m24h/espcnc/Readme.txt

A 3D printer or CNC controller using ESP32 module
Using DMA/FIFO buffered I2S port to output step pulses
