m24h/espcnc/hardware/espcnc_print.pdf

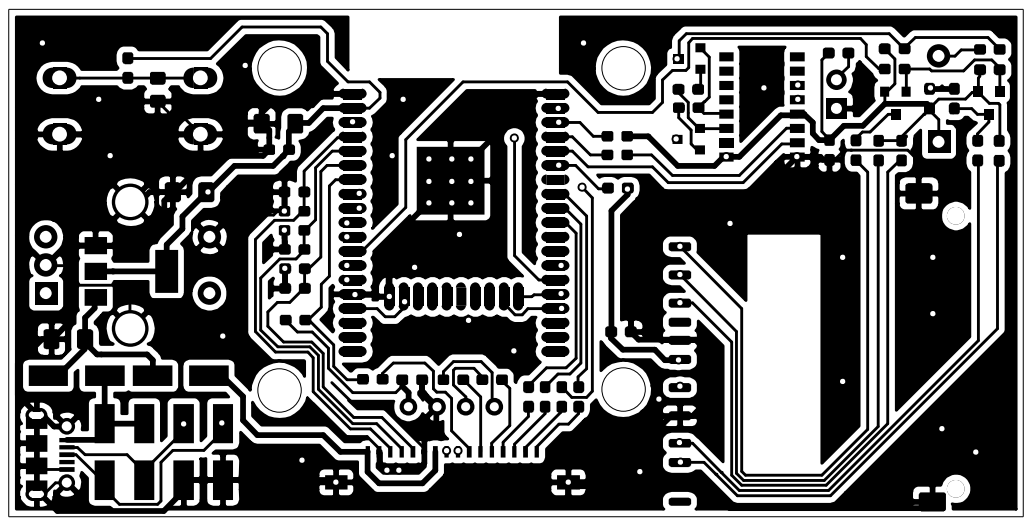
[picture p1: page 1]

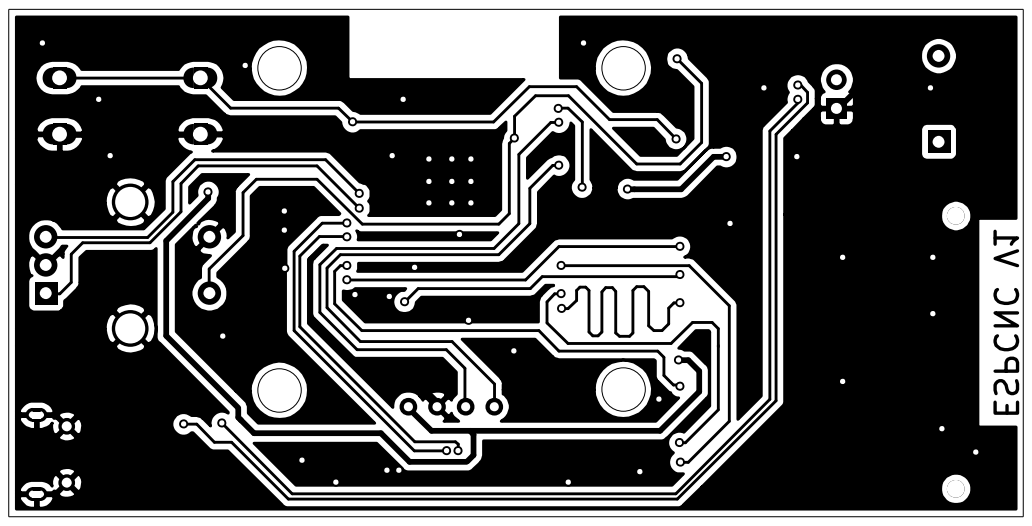
[picture p2: page 2]

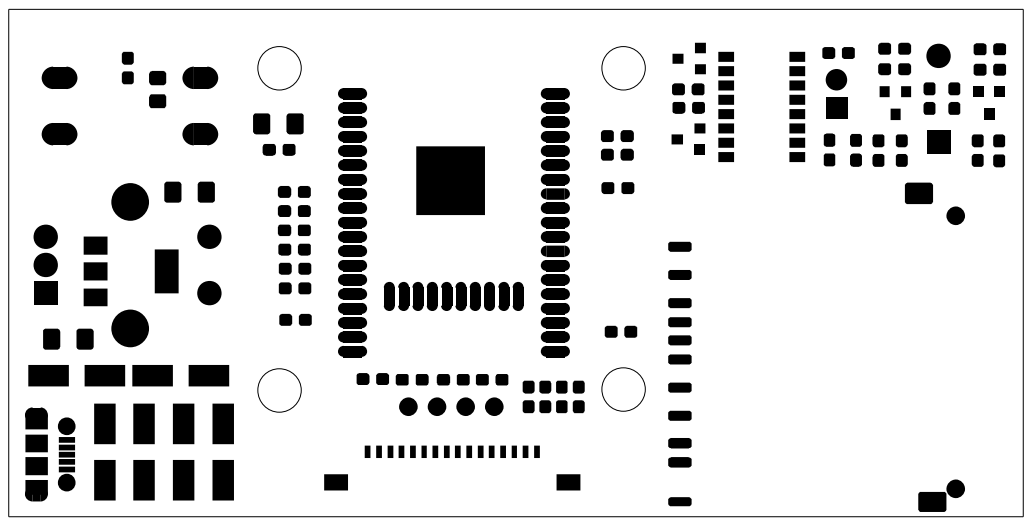
[picture p3: page 3]

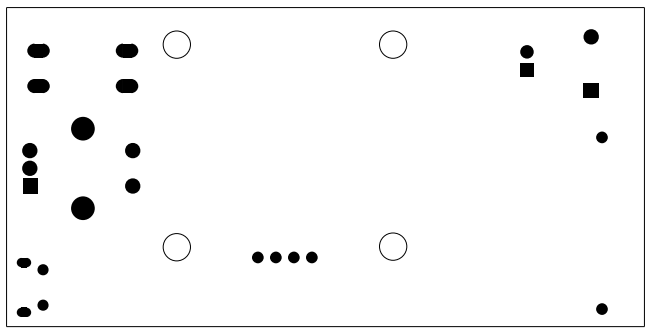
[picture p4: figure]
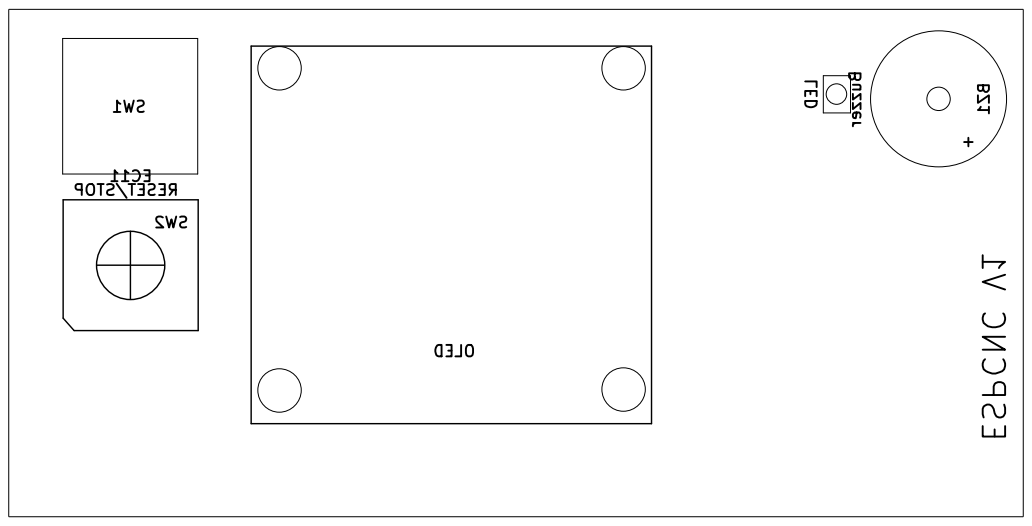
[picture p5: page 5]
