m24h/espcnc/hardware/driver.kicad_pcb

## KiCad design hardware/driver.kicad_pcb (2020-03-21)

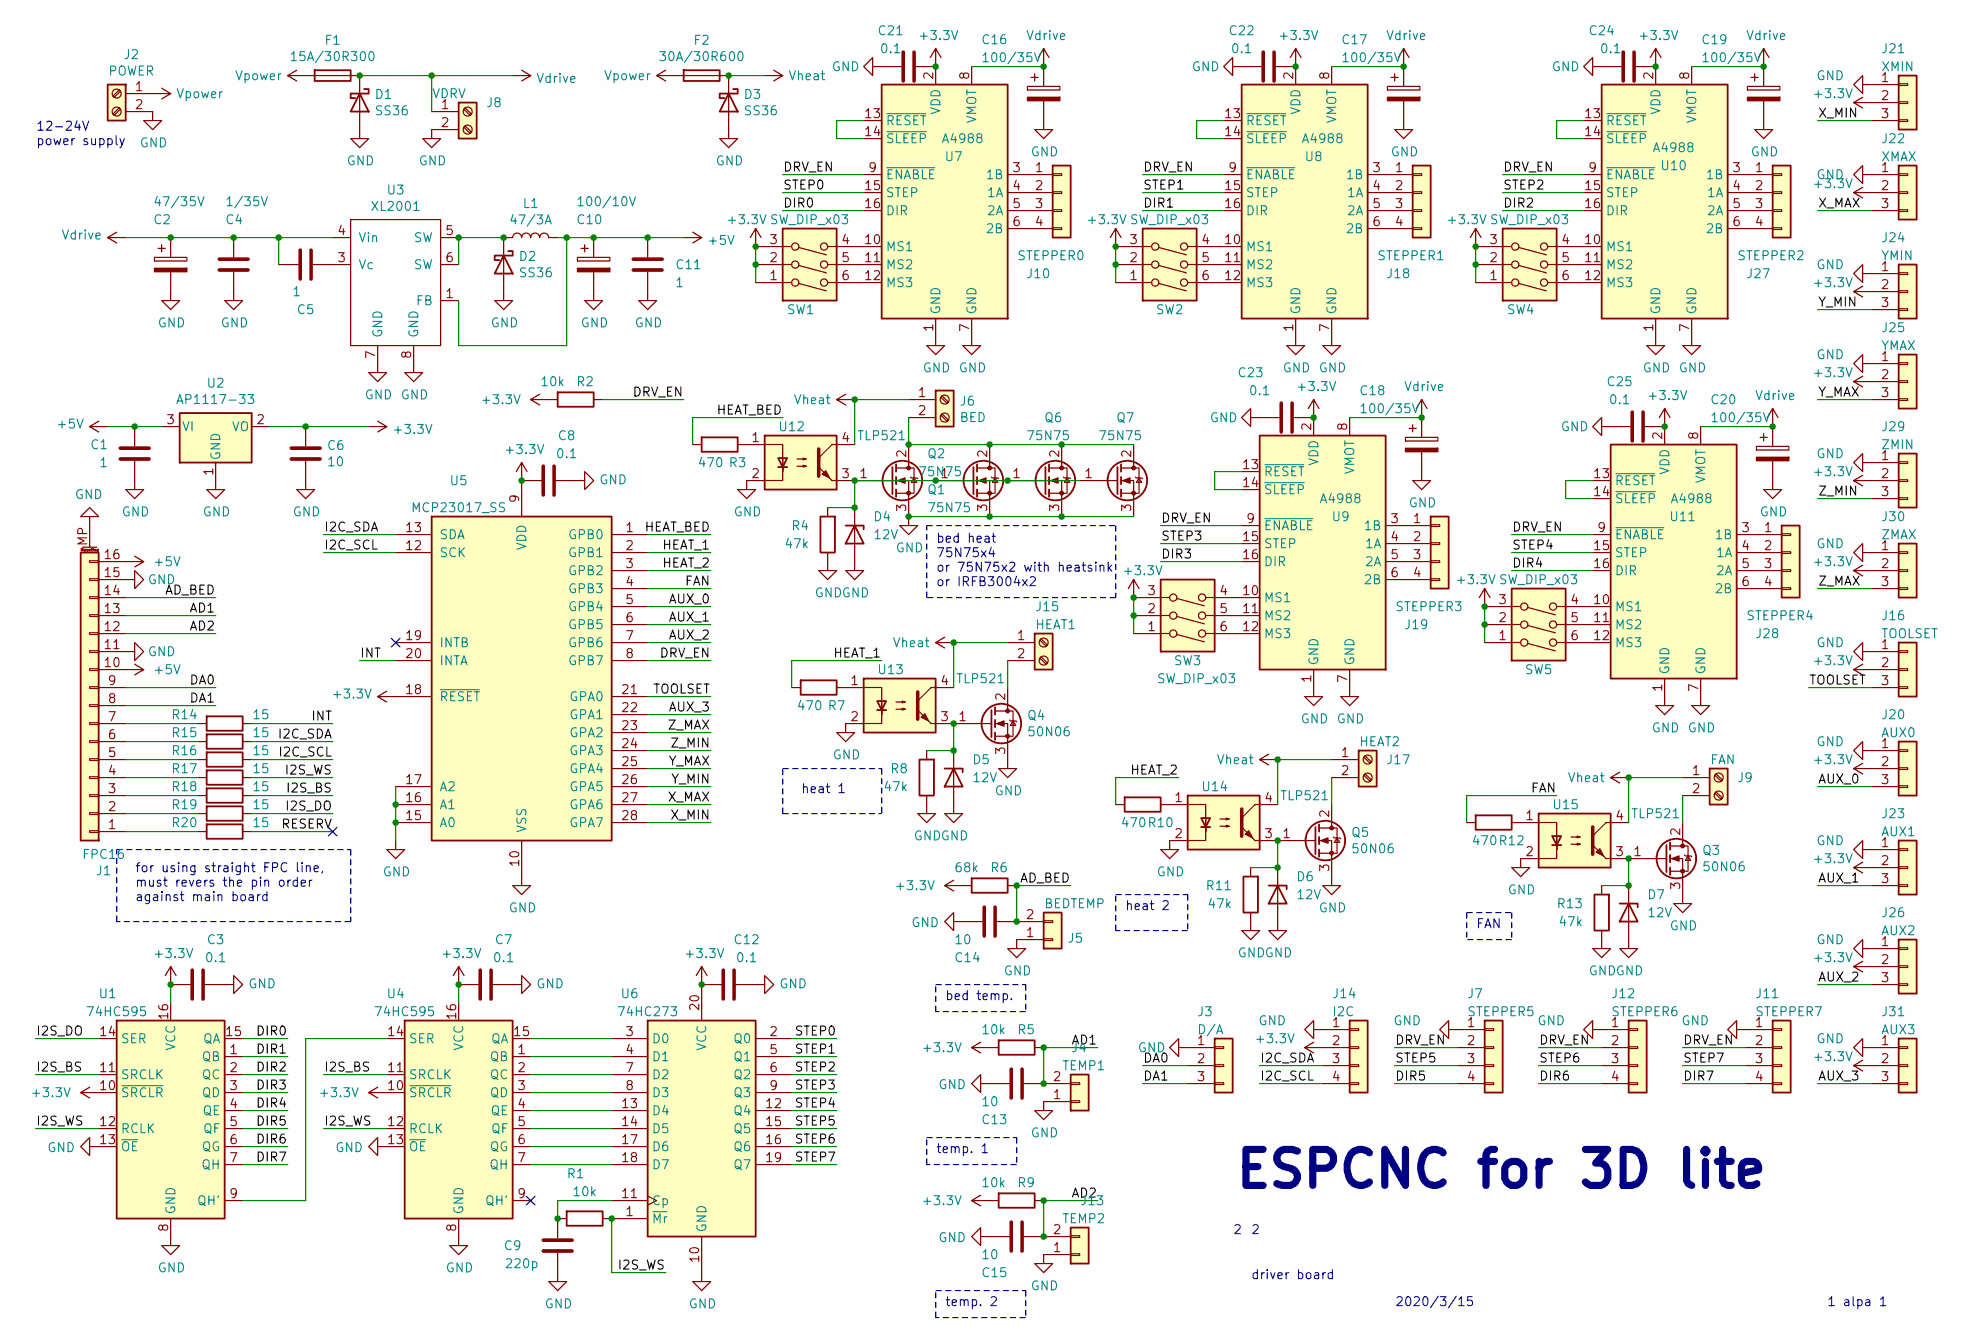
[picture p12: schematic driver.sch]

Parts:
C1, C5, C11: 1; C_0805_2012Metric_Pad1.15x1.40mm_HandSolder
C2: 47/35V; CP_Radial_D6.3mm_P2.50mm
C3, C7, C8, C12, C21, C22, C23, C24, C25: 0.1; C_0603_1608Metric_Pad1.05x0.95mm_HandSolder
C4: 1/35V; C_0805_2012Metric_Pad1.15x1.40mm_HandSolder
C6, C13, C14, C15: 10; C_1206_3216Metric_Pad1.42x1.75mm_HandSolder
C9: 220p; C_0603_1608Metric_Pad1.05x0.95mm_HandSolder
C10: 100/10V; CP_Radial_D6.3mm_P2.50mm
C16, C17, C18, C19, C20: 100/35V; CP_Radial_D6.3mm_P2.50mm
D1, D2, D3: SS36; D_SMA_Handsoldering
D4, D5, D6, D7: 12V; D_DO-41_SOD81_P2.54mm_Vertical_KathodeUp
F1: 15A/30R300; Fuse_Bourns_MF-RG300
F2: 30A/30R600; Fuse_Bourns_MF-RG500
J1: FPC16; Molex_200528-0160_1x16-1MP_P1.00mm_Horizontal
J2: POWER; TerminalBlock_bornier-2_P5.08mm
J3: D/A; PinHeader_1x03_P2.54mm_Vertical
J4: TEMP1; PinHeader_1x02_P2.54mm_Vertical
J5: BEDTEMP; PinHeader_1x02_P2.54mm_Vertical
J6: BED; TerminalBlock_bornier-2_P5.08mm
J7: STEPPER5; PinHeader_1x04_P2.54mm_Vertical
J8: VDRV; TerminalBlock_bornier-2_P5.08mm
J9: FAN; TerminalBlock_bornier-2_P5.08mm
J10: STEPPER0; PinHeader_1x04_P2.54mm_Vertical
J11: STEPPER7; PinHeader_1x04_P2.54mm_Vertical
J12: STEPPER6; PinHeader_1x04_P2.54mm_Vertical
J13: TEMP2; PinHeader_1x02_P2.54mm_Vertical
J14: I2C; PinHeader_1x04_P2.54mm_Vertical
J15: HEAT1; TerminalBlock_bornier-2_P5.08mm
J16: TOOLSET; PinHeader_1x03_P2.54mm_Vertical
J17: HEAT2; TerminalBlock_bornier-2_P5.08mm
J18: STEPPER1; PinHeader_1x04_P2.54mm_Vertical
J19: STEPPER3; PinHeader_1x04_P2.54mm_Vertical
J20: AUX0; PinHeader_1x03_P2.54mm_Vertical
J21: XMIN; PinHeader_1x03_P2.54mm_Vertical
J22: XMAX; PinHeader_1x03_P2.54mm_Vertical
J23: AUX1; PinHeader_1x03_P2.54mm_Vertical
J24: YMIN; PinHeader_1x03_P2.54mm_Vertical
J25: YMAX; PinHeader_1x03_P2.54mm_Vertical
J26: AUX2; PinHeader_1x03_P2.54mm_Vertical
J27: STEPPER2; PinHeader_1x04_P2.54mm_Vertical
J28: STEPPER4; PinHeader_1x04_P2.54mm_Vertical
J29: ZMIN; PinHeader_1x03_P2.54mm_Vertical
J30: ZMAX; PinHeader_1x03_P2.54mm_Vertical
J31: AUX3; PinHeader_1x03_P2.54mm_Vertical
L1: 47/3A; L_Toroid_Horizontal_D7.8mm_P13.00mm_Diameter9-5mm_Amidon-T30
Q1, Q2, Q6, Q7: 75N75; TO-220-3_Vertical
Q3, Q4, Q5: 50N06; TO-220-3_Vertical
R1, R2, R5, R9: 10k; R_0603_1608Metric_Pad1.05x0.95mm_HandSolder
R3, R7, R10, R12: 470; R_0603_1608Metric_Pad1.05x0.95mm_HandSolder
R4, R8, R11, R13: 47k; R_0603_1608Metric_Pad1.05x0.95mm_HandSolder
R6: 68k; R_0603_1608Metric_Pad1.05x0.95mm_HandSolder
R14, R15, R16, R17, R18, R19, R20: 15; R_0603_1608Metric_Pad1.05x0.95mm_HandSolder
SW1, SW2, SW3, SW4, SW5: SW_DIP_x03; DIP-6_W7.62mm
U1, U4: 74HC595; SOP-16_4.55x10.3mm_P1.27mm
U2: AP1117-33; SOT-223-3_TabPin2
U3: XL2001; SOP-8_5.28x5.23mm_P1.27mm
U5: MCP23017_SS; SSOP-28_5.3x10.2mm_P0.65mm
U6: 74HC273; SOIC-20W_7.5x12.8mm_P1.27mm
U7, U8, U9, U10, U11: A4988; Pololu_Breakout-16_15.2x20.3mm
U12, U13, U14, U15: TLP521; DIP-4_W7.62mm

Connections:
+3V3: C3.2, C6.1, C7.2, C8.2, C12.2, C21.1, C22.1, C23.1, C24.1, C25.1, J14.2, J16.2, J20.2, J21.2, J22.2, J23.2, J24.2, J25.2, J26.2, J29.2, J30.2, J31.2, R2.2, R5.2, R6.2, R9.2, SW1.1, SW1.2, SW1.3, SW2.1, SW2.2, SW2.3, SW3.1, SW3.2, SW3.3, SW4.1, SW4.2, SW4.3, SW5.1, SW5.2, SW5.3, U1.10 (~SRCLR), U1.16 (VCC), U2.2 (VO), U4.10 (~SRCLR), U4.16 (VCC), U5.9 (VDD), U5.18 (~RESET~), U6.20 (VCC), U7.2 (VDD), U8.2 (VDD), U9.2 (VDD), U10.2 (VDD), U11.2 (VDD)
+5V: C1.1, C10.1, C11.1, J1.10, J1.16, L1.2, U2.3 (VI), U3.1 (FB)
/AD1: C13.1, J1.13, J4.2, R5.1
/AD2: C15.1, J1.12, J13.2, R9.1
/AD_BED: C14.1, J1.14, J5.2, R6.1
/AUX_0: J20.3, U5.5 (GPB4)
/AUX_1: J23.3, U5.6 (GPB5)
/AUX_2: J26.3, U5.7 (GPB6)
/AUX_3: J31.3, U5.22 (GPA1)
/DA0: J1.9, J3.2
/DA1: J1.8, J3.3
/DIR0: U1.15 (QA), U7.16 (DIR)
/DIR1: U1.1 (QB), U8.16 (DIR)
/DIR2: U1.2 (QC), U10.16 (DIR)
/DIR3: U1.3 (QD), U9.16 (DIR)
/DIR4: U1.4 (QE), U11.16 (DIR)
/DIR5: J7.4, U1.5 (QF)
/DIR6: J12.4, U1.6 (QG)
/DIR7: J11.4, U1.7 (QH)
/DRV_EN: J7.2, J11.2, J12.2, R2.1, U5.8 (GPB7), U7.9 (~ENABLE), U8.9 (~ENABLE), U9.9 (~ENABLE), U10.9 (~ENABLE), U11.9 (~ENABLE)
/FAN: R12.2, U5.4 (GPB3)
/HEAT_1: R7.2, U5.2 (GPB1)
/HEAT_2: R10.2, U5.3 (GPB2)
/HEAT_BED: R3.2, U5.1 (GPB0)
/I2C_SCL: J14.4, R16.1, U5.12 (SCK)
/I2C_SDA: J14.3, R15.1, U5.13 (SDA)
/I2S_BS: R18.1, U1.11 (SRCLK), U4.11 (SRCLK)
/I2S_DO: R19.1, U1.14 (SER)
/I2S_WS: R1.1, R17.1, U1.12 (RCLK), U4.12 (RCLK), U6.1 (~Mr)
/INT: R14.1, U5.20 (INTA)
/RESERV: R20.1
/STEP0: U6.2 (Q0), U7.15 (STEP)
/STEP1: U6.5 (Q1), U8.15 (STEP)
/STEP2: U6.6 (Q2), U10.15 (STEP)
/STEP3: U6.9 (Q3), U9.15 (STEP)
/STEP4: U6.12 (Q4), U11.15 (STEP)
/STEP5: J7.3, U6.15 (Q5)
/STEP6: J12.3, U6.16 (Q6)
/STEP7: J11.3, U6.19 (Q7)
/TOOLSET: J16.3, U5.21 (GPA0)
/X_MAX: J22.3, U5.27 (GPA6)
/X_MIN: J21.3, U5.28 (GPA7)
/Y_MAX: J25.3, U5.25 (GPA4)
/Y_MIN: J24.3, U5.26 (GPA5)
/Z_MAX: J30.3, U5.23 (GPA2)
/Z_MIN: J29.3, U5.24 (GPA3)
GND: C1.2, C2.2, C3.1, C4.2, C6.2, C7.1, C8.1, C9.1, C10.2, C11.2, C12.1, C13.2, C14.2, C15.2, C16.2, C17.2, C18.2, C19.2, C20.2, C21.2, C22.2, C23.2, C24.2, C25.2, D1.2 (A), D2.2 (A), D3.2 (A), D4.2 (A), D5.2 (A), D6.2 (A), D7.2 (A), J1.11, J1.15, J1.MP (MountPin), J2.2, J3.1, J4.1, J5.1, J7.1, J8.2, J11.1, J12.1, J13.1, J14.1, J16.1, J20.1, J21.1, J22.1, J23.1, J24.1, J25.1, J26.1, J29.1, J30.1, J31.1, Q1.3 (S), Q2.3 (S), Q3.3 (S), Q4.3 (S), Q5.3 (S), Q6.3 (S), Q7.3 (S), R4.1, R8.1, R11.1, R13.1, U1.8 (GND), U1.13 (~OE), U2.1 (GND), U3.7 (GND), U3.8 (GND), U4.8 (GND), U4.13 (~OE), U5.10 (VSS), U5.15 (A0), U5.16 (A1), U5.17 (A2), U6.10 (GND), U7.1 (GND), U7.7 (GND), U8.1 (GND), U8.7 (GND), U9.1 (GND), U9.7 (GND), U10.1 (GND), U10.7 (GND), U11.1 (GND), U11.7 (GND), U12.2, U13.2, U14.2, U15.2
unnamed: C5.1, U3.3 (Vc)
unnamed: C9.2, R1.2, U6.11 (Cp)
unnamed: D2.1 (K), L1.1, U3.5 (SW), U3.6 (SW)
unnamed: D4.1 (K), Q1.1 (G), Q2.1 (G), Q6.1 (G), Q7.1 (G), R4.2, U12.3
unnamed: D5.1 (K), Q4.1 (G), R8.2, U13.3
unnamed: D6.1 (K), Q5.1 (G), R11.2, U14.3
unnamed: D7.1 (K), Q3.1 (G), R13.2, U15.3
unnamed: J1.1, R20.2
unnamed: J1.2, R19.2
unnamed: J1.3, R18.2
unnamed: J1.4, R17.2
unnamed: J1.5, R16.2
unnamed: J1.6, R15.2
unnamed: J1.7, R14.2
unnamed: J6.2, Q1.2 (D), Q2.2 (D), Q6.2 (D), Q7.2 (D)
unnamed: J9.2, Q3.2 (D)
unnamed: J10.1, U7.3 (1B)
unnamed: J10.2, U7.4 (1A)
unnamed: J10.3, U7.5 (2A)
unnamed: J10.4, U7.6 (2B)
unnamed: J15.2, Q4.2 (D)
unnamed: J17.2, Q5.2 (D)
unnamed: J18.1, U8.3 (1B)
unnamed: J18.2, U8.4 (1A)
unnamed: J18.3, U8.5 (2A)
unnamed: J18.4, U8.6 (2B)
unnamed: J19.1, U9.3 (1B)
unnamed: J19.2, U9.4 (1A)
unnamed: J19.3, U9.5 (2A)
unnamed: J19.4, U9.6 (2B)
unnamed: J27.1, U10.3 (1B)
unnamed: J27.2, U10.4 (1A)
unnamed: J27.3, U10.5 (2A)
unnamed: J27.4, U10.6 (2B)
unnamed: J28.1, U11.3 (1B)
unnamed: J28.2, U11.4 (1A)
unnamed: J28.3, U11.5 (2A)
unnamed: J28.4, U11.6 (2B)
unnamed: R3.1, U12.1
unnamed: R7.1, U13.1
unnamed: R10.1, U14.1
unnamed: R12.1, U15.1
unnamed: SW1.4, U7.10 (MS1)
unnamed: SW1.5, U7.11 (MS2)
unnamed: SW1.6, U7.12 (MS3)
unnamed: SW2.4, U8.10 (MS1)
unnamed: SW2.5, U8.11 (MS2)
unnamed: SW2.6, U8.12 (MS3)
unnamed: SW3.4, U9.10 (MS1)
unnamed: SW3.5, U9.11 (MS2)
unnamed: SW3.6, U9.12 (MS3)
unnamed: SW4.4, U10.10 (MS1)
unnamed: SW4.5, U10.11 (MS2)
unnamed: SW4.6, U10.12 (MS3)
unnamed: SW5.4, U11.10 (MS1)
unnamed: SW5.5, U11.11 (MS2)
unnamed: SW5.6, U11.12 (MS3)
unnamed: U1.9 (QH'), U4.14 (SER)
unnamed: U4.1 (QB), U6.4 (D1)
unnamed: U4.2 (QC), U6.7 (D2)
unnamed: U4.3 (QD), U6.8 (D3)
unnamed: U4.4 (QE), U6.13 (D4)
unnamed: U4.5 (QF), U6.14 (D5)
unnamed: U4.6 (QG), U6.17 (D6)
unnamed: U4.7 (QH), U6.18 (D7)
unnamed: U4.15 (QA), U6.3 (D0)
unnamed: U7.13 (~RESET), U7.14 (~SLEEP)
unnamed: U8.13 (~RESET), U8.14 (~SLEEP)
unnamed: U9.13 (~RESET), U9.14 (~SLEEP)
unnamed: U10.13 (~RESET), U10.14 (~SLEEP)
unnamed: U11.13 (~RESET), U11.14 (~SLEEP)
Vdrive: C2.1, C4.1, C5.2, C16.1, C17.1, C18.1, C19.1, C20.1, D1.1 (K), F1.1, J8.1, U3.4 (Vin), U7.8 (VMOT), U8.8 (VMOT), U9.8 (VMOT), U10.8 (VMOT), U11.8 (VMOT)
Vheat: D3.1 (K), F2.1, J6.1, J9.1, J15.1, J17.1, U12.4, U13.4, U14.4, U15.4
Vpower: F1.2, F2.2, J2.1

Notes on the sheet:
ESPCNC for 3D lite
2020/3/15
driver board
1 alpa 1
bed temp.
12-24V power supply
bed heat 75N75x4 or 75N75x2 with heatsink or IRFB3004x2
heat 2
heat 1
temp. 1
temp. 2
FAN
for using straight FPC line, must revers the pin order against main board

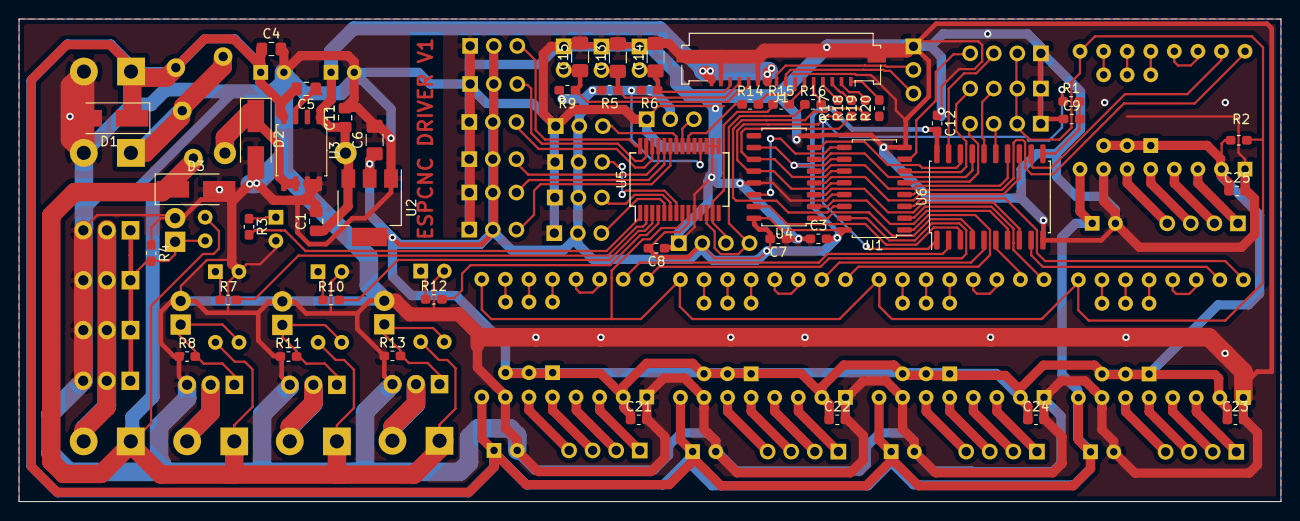
[picture p13: board driver.kicad_pcb from above]

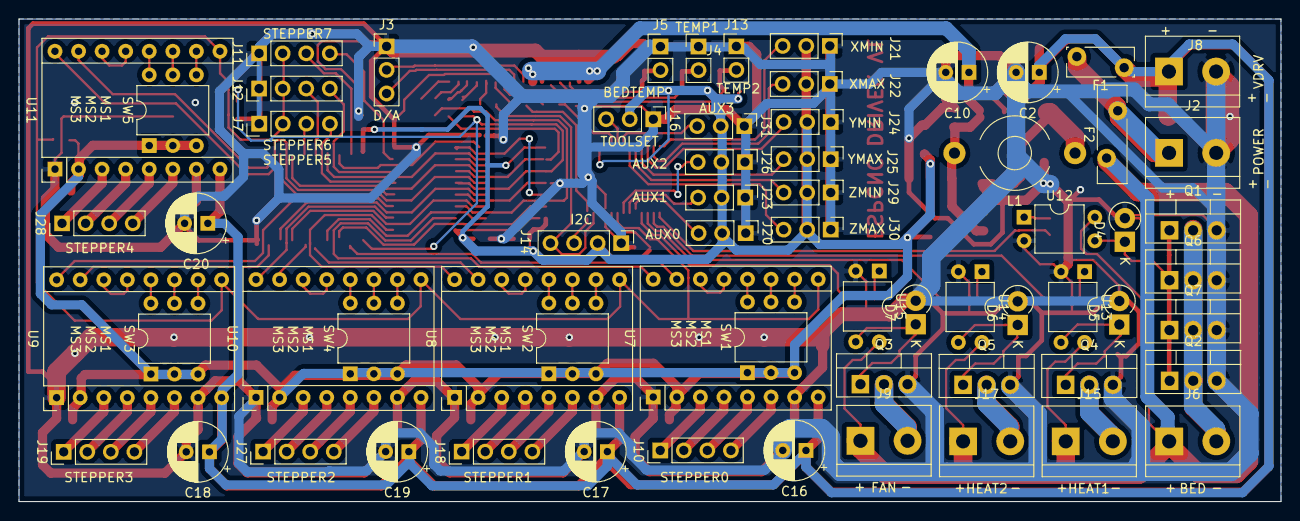
[picture p14: board driver.kicad_pcb from below]

Board: 2 copper layers, 136.0 x 52.0 mm, 113 parts (65 on the bottom side), 120 nets.
