m24h/espcnc/hardware/espcnc.kicad_pcb

## KiCad design hardware/espcnc.kicad_pcb (2020-03-21)

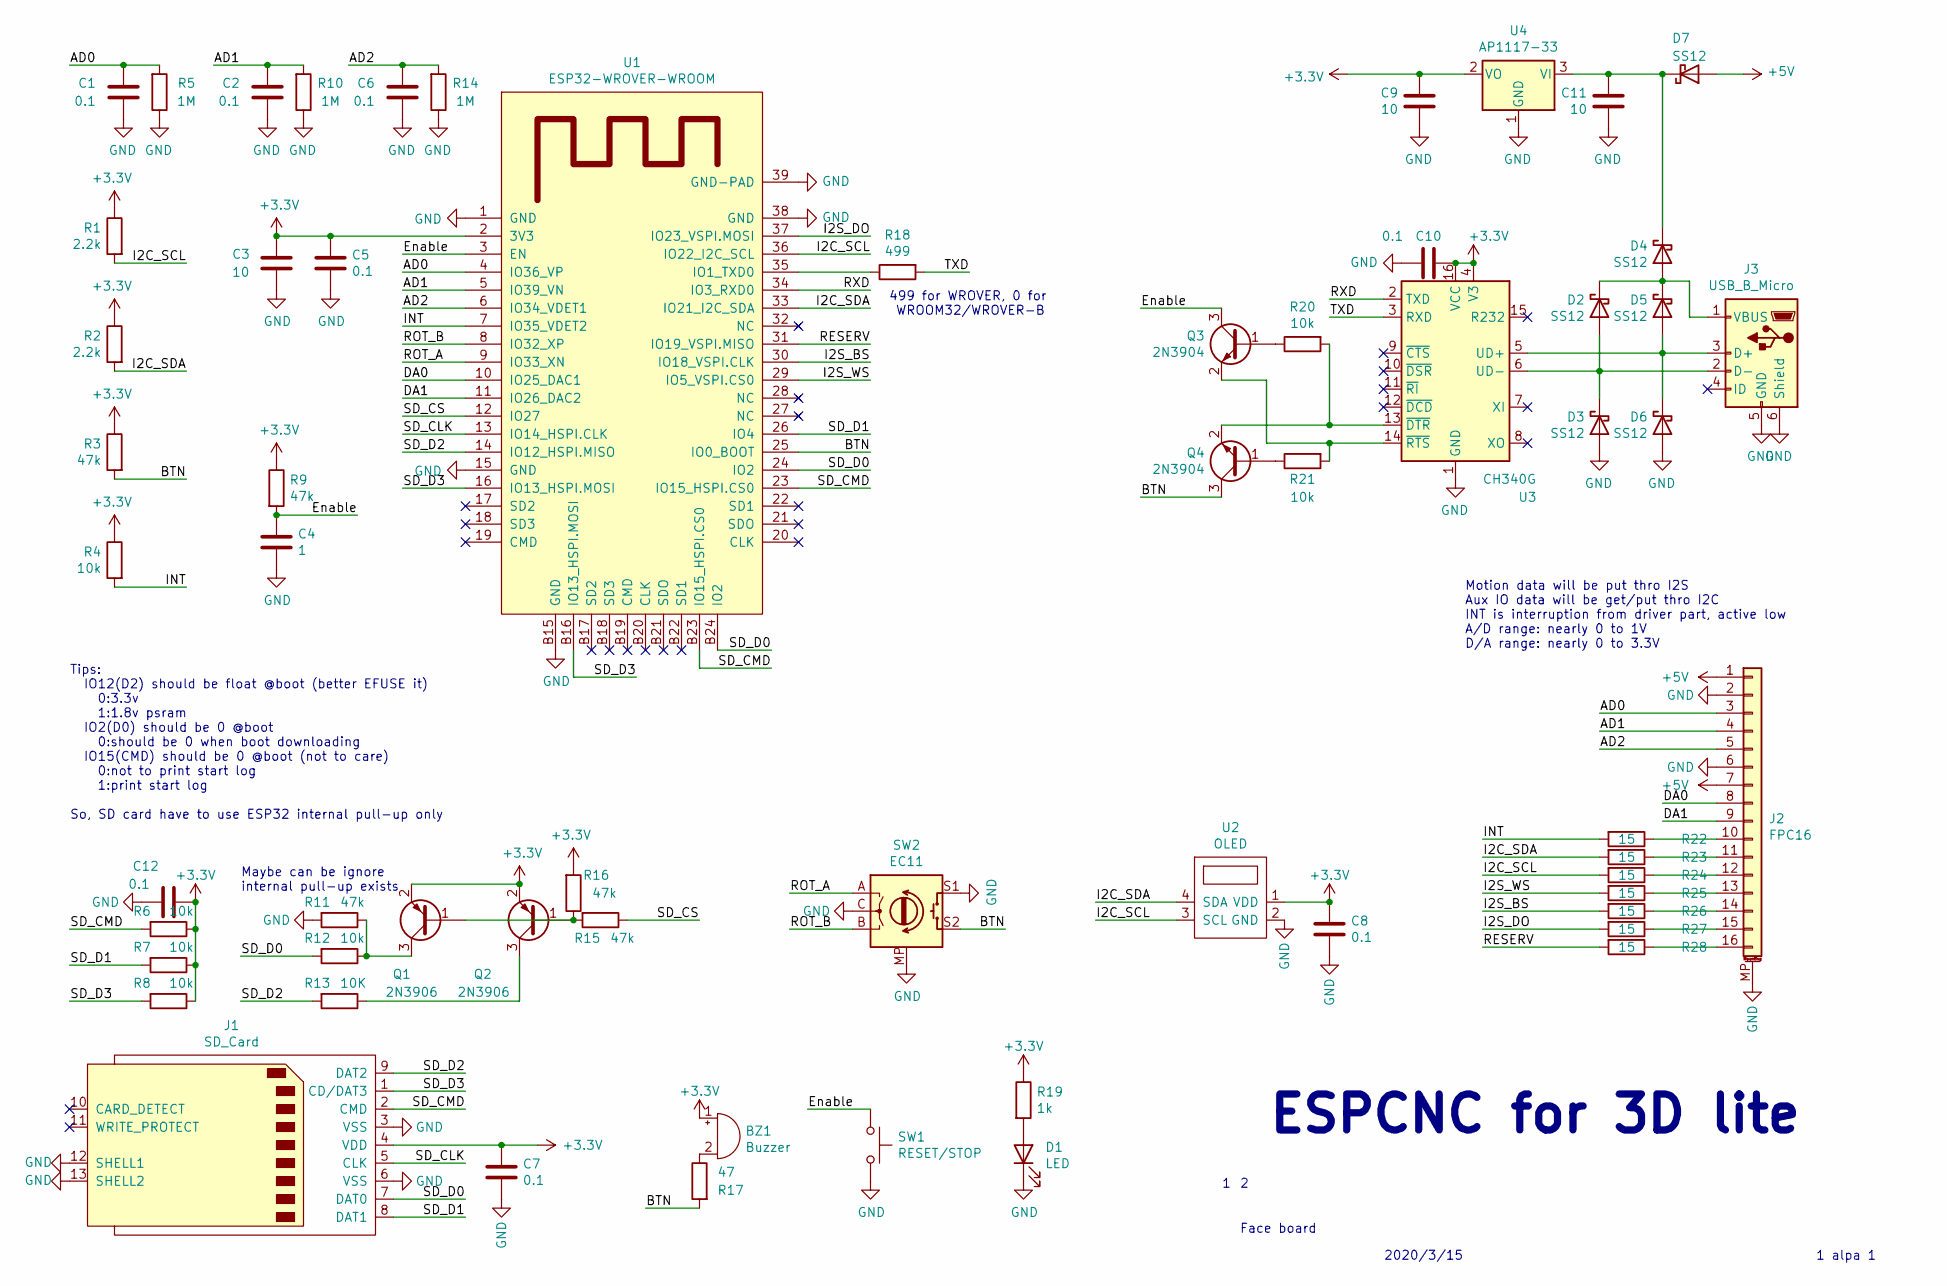
[picture p15: schematic espcnc.sch]

Parts:
BZ1: Buzzer; Buzzer_12x9.5RM7.6
C1, C2, C5, C6, C7, C8, C10, C12: 0.1; C_0603_1608Metric_Pad1.05x0.95mm_HandSolder
C3, C9, C11: 10; C_1206_3216Metric_Pad1.42x1.75mm_HandSolder
C4: 1; C_0805_2012Metric_Pad1.15x1.40mm_HandSolder
D1: LED; LED_D1.8mm_W3.3mm_H2.4mm
D2, D3, D4, D5, D6, D7: SS12; D_SMA_Handsoldering
J1: SD_Card; SD_CARD
J2: FPC16; Molex_200528-0160_1x16-1MP_P1.00mm_Horizontal
J3: USB_B_Micro; USB_Micro-B_Molex-105017-0001
Q1, Q2: 2N3906; SOT-23
Q3, Q4: 2N3904; SOT-23
R1, R2: 2.2k; R_0603_1608Metric_Pad1.05x0.95mm_HandSolder
R3, R9, R11, R15, R16: 47k; R_0603_1608Metric_Pad1.05x0.95mm_HandSolder
R4, R6, R7, R8, R12, R20, R21: 10k; R_0603_1608Metric_Pad1.05x0.95mm_HandSolder
R5, R10, R14: 1M; R_0603_1608Metric_Pad1.05x0.95mm_HandSolder
R13: 10K; R_0603_1608Metric_Pad1.05x0.95mm_HandSolder
R17: 47; R_0603_1608Metric_Pad1.05x0.95mm_HandSolder
R18: 499; R_0603_1608Metric_Pad1.05x0.95mm_HandSolder
R19: 1k; R_0603_1608Metric_Pad1.05x0.95mm_HandSolder
R22, R23, R24, R25, R26, R27, R28: 15; R_0603_1608Metric_Pad1.05x0.95mm_HandSolder
SW1: RESET/STOP; SW_PUSH-12mm
SW2: EC11; RotaryEncoder_Alps_EC11E-Switch_Vertical_H20mm_CircularMoun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
U1: ESP32-WROVER-WROOM
U2: OLED; 1.3_inch_i2c_oled_128x64_jinyichen
U3: CH340G; SOP-16_4.4x10.4mm_P1.27mm
U4: AP1117-33; SOT-223-3_TabPin2

Connections:
+3V3: BZ1.1 (-), C3.1, C5.1, C7.1, C8.1, C9.1, C10.2, C12.2, J1.4 (VDD), Q1.2 (E), Q2.2 (E), R1.1, R2.1, R3.1, R4.1, R6.1, R7.1, R8.1, R9.1, R16.2, R19.1, U1.2 (3V3), U2.1 (VDD), U3.4 (V3), U3.16 (VCC), U4.2 (VO)
+5V: D7.2 (A), J2.1, J2.7
/AD0: C1.1, J2.3, R5.2, U1.4 (IO36_VP)
/AD1: C2.1, J2.4, R10.2, U1.5 (IO39_VN)
/AD2: C6.1, J2.5, R14.2, U1.6 (IO34_VDET1)
/BTN: Q4.3 (C), R3.2, R17.2, SW2.S2, U1.25 (IO0_BOOT)
/DA0: J2.8, U1.10 (IO25_DAC1)
/DA1: J2.9, U1.11 (IO26_DAC2)
/Enable: C4.1, Q3.3 (C), R9.2, SW1.1, U1.3 (EN)
/I2C_SCL: R1.2, R24.2, U1.36 (IO22_I2C_SCL), U2.3 (SCL)
/I2C_SDA: R2.2, R23.2, U1.33 (IO21_I2C_SDA), U2.4 (SDA)
/I2S_BS: R26.2, U1.30 (IO18_VSPI.CLK)
/I2S_DO: R27.2, U1.37 (IO23_VSPI.MOSI)
/I2S_WS: R25.2, U1.29 (IO5_VSPI.CS0)
/INT: R4.2, R22.2, U1.7 (IO35_VDET2)
/RESERV: R28.2, U1.31 (IO19_VSPI.MISO)
/ROT_A: SW2.A, U1.9 (IO33_XN)
/ROT_B: SW2.B, U1.8 (IO32_XP)
/RXD: U1.34 (IO3_RXD0), U3.2 (TXD)
/SD_CLK: J1.5 (CLK), U1.13 (IO14_HSPI.CLK)
/SD_CMD: J1.2 (CMD), R6.2, U1.23 (IO15_HSPI.CS0), U1.B23 (IO15_HSPI.CS0)
/SD_CS: R15.1, U1.12 (IO27)
/SD_D0: J1.7 (DAT0), R12.2, U1.24 (IO2), U1.B24 (IO2)
/SD_D1: J1.8 (DAT1), R7.2, U1.26 (IO4)
/SD_D2: J1.9 (DAT2), R13.2, U1.14 (IO12_HSPI.MISO)
/SD_D3: J1.1 (CD/DAT3), R8.2, U1.16 (IO13_HSPI.MOSI), U1.B16 (IO13_HSPI.MOSI)
/TXD: R18.2, U3.3 (RXD)
GND: C1.2, C2.2, C3.2, C4.2, C5.2, C6.2, C7.2, C8.2, C9.2, C10.1, C11.2, C12.1, D1.1 (K), D3.2 (A), D6.2 (A), J1.3 (VSS), J1.6 (VSS), J1.12 (SHELL1), J1.13 (SHELL2), J2.2, J2.6, J2.MP (MountPin), J3.5 (GND), J3.6 (Shield), R5.1, R10.1, R11.2, R14.1, SW1.2, SW2.C, SW2.MP, SW2.S1, U1.1 (GND), U1.15 (GND), U1.38 (GND), U1.39 (GND-PAD), U1.B15 (GND), U2.2 (GND), U3.1 (GND), U4.1 (GND)
unnamed: BZ1.2 (+), R17.1
unnamed: C11.1, D4.1 (K), D7.1 (K), U4.3 (VI)
unnamed: D1.2 (A), R19.2
unnamed: D2.1 (K), D4.2 (A), D5.1 (K), J3.1 (VBUS)
unnamed: D2.2 (A), D3.1 (K), J3.2 (D-), U3.6 (UD-)
unnamed: D5.2 (A), D6.1 (K), J3.3 (D+), U3.5 (UD+)
unnamed: J2.10, R22.1
unnamed: J2.11, R23.1
unnamed: J2.12, R24.1
unnamed: J2.13, R25.1
unnamed: J2.14, R26.1
unnamed: J2.15, R27.1
unnamed: J2.16, R28.1
unnamed: Q1.1 (B), Q2.1 (B), R15.2, R16.1
unnamed: Q1.3 (C), R11.1, R12.1
unnamed: Q2.3 (C), R13.1
unnamed: Q3.1 (B), R20.1
unnamed: Q3.2 (E), R21.2, U3.14 (~RTS)
unnamed: Q4.1 (B), R21.1
unnamed: Q4.2 (E), R20.2, U3.13 (~DTR)
unnamed: R18.1, U1.35 (IO1_TXD0)

Notes on the sheet:
ESPCNC for 3D lite
2020/3/15
Face board
1 alpa 1
499 for WROVER, 0 for WROOM32/WROVER-B
Tips: IO12(D2) should be float @boot (better EFUSE it) 0:3.3v 1:1.8v psram IO2(D0) should be 0 @boot 0:should be 0 when boot downloading IO15(CMD) should be 0 @boot (not to care) 0:not to print start log 1:print start log So, SD card have to use ESP32 internal pull-up only
Maybe can be ignore internal pull-up exists
Motion data will be put thro I2S Aux IO data will be get/put thro I2C INT is interruption from driver part, active low A/D range: nearly 0 to 1V D/A range: nearly 0 to 3.3V

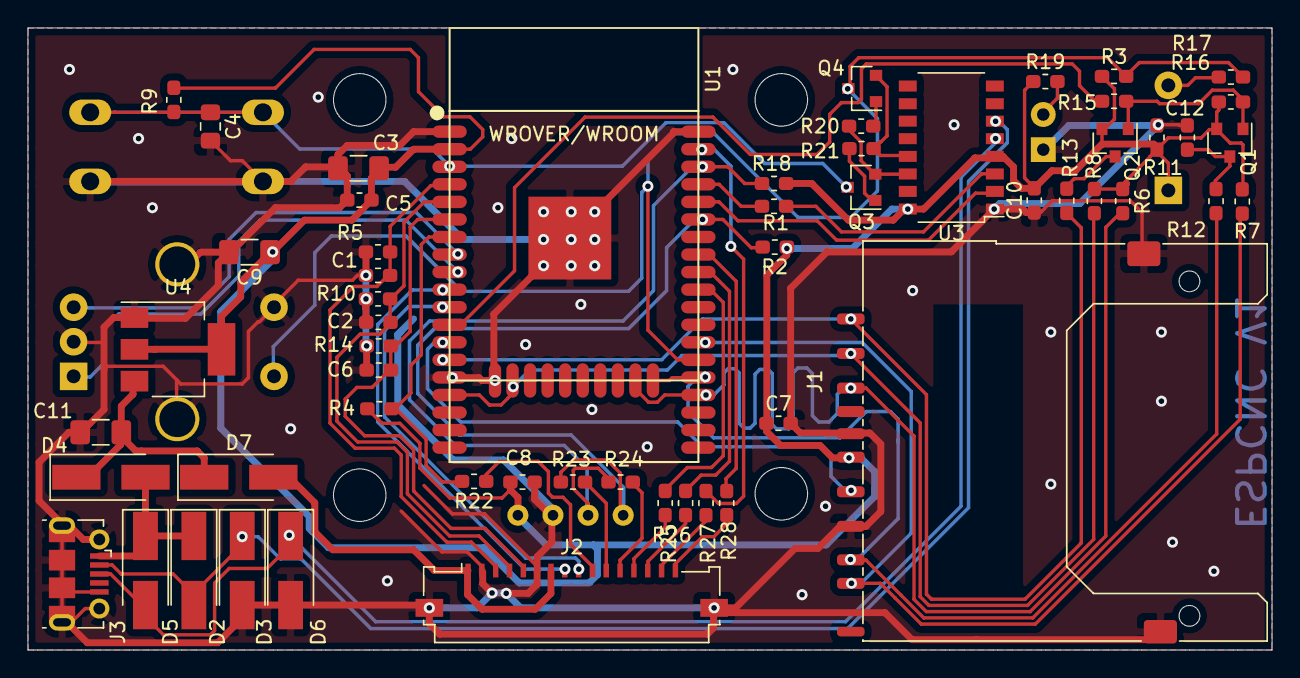
[picture p16: board espcnc.kicad_pcb from above]

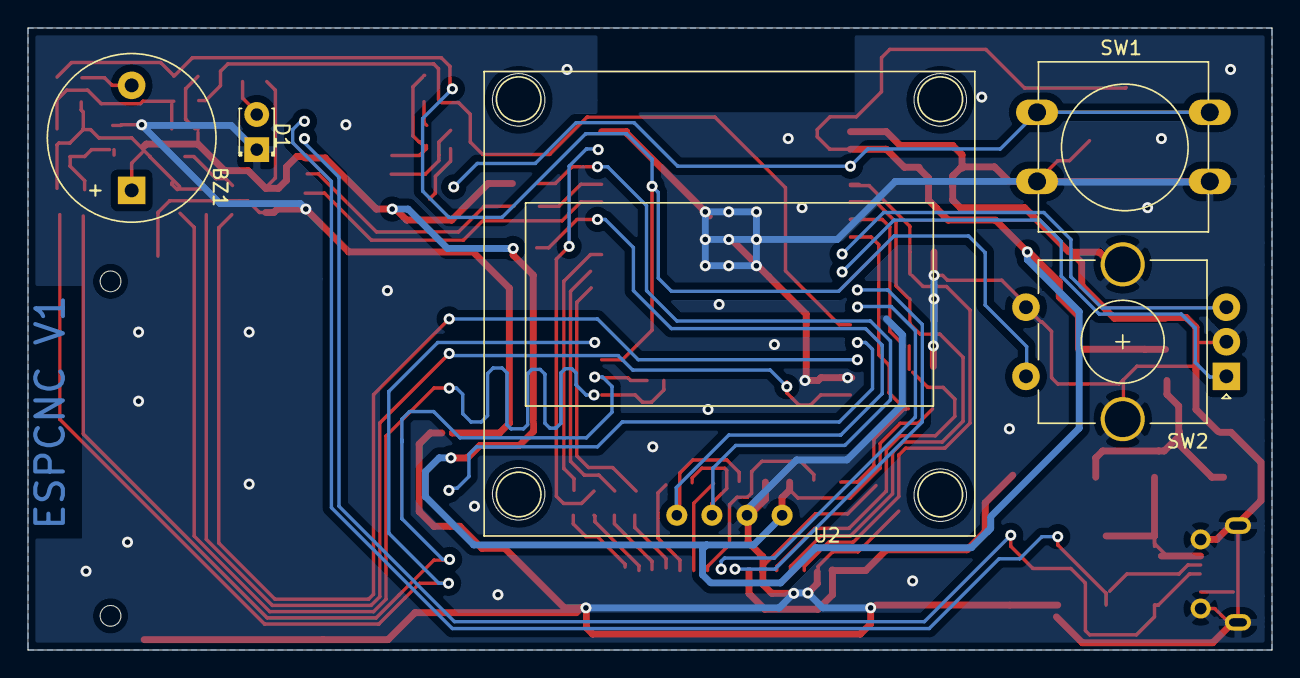
[picture p17: board espcnc.kicad_pcb from below]

Board: 2 copper layers, 90.0 x 45.0 mm, 61 parts (5 on the bottom side), 49 nets.
