m24h/espcnc/(commit log)

2020-03-20 Trying start
    hardware first, now the sch/pcb is OK
    [driver-B_Cu.gbl, driver-B_Mask.gbs, driver-B_SilkS.gbo, driver-Edge_Cuts.gm1, driver-F_Cu.gtl, driver-F_Mask.gts, driver-F_SilkS.gto, driver-NPTH-drl_map.gbr]
2020-03-20 Added logo to espcnc PCB
    [espcnc-B_Cu.gbr, espcnc-B_Mask.gbr, espcnc-B_Paste.gbr, espcnc-B_SilkS.gbr, espcnc-Edge_Cuts.gbr, espcnc-F_Cu.gbr, espcnc-F_Mask.gbr, espcnc-F_Paste.gbr]
2020-03-20 Add comment words on driver pcb silk layer
    [driver-B_Cu.gbl, driver-B_Mask.gbs, driver-B_SilkS.gbo, driver-Edge_Cuts.gm1, driver-F_Cu.gtl, driver-F_Mask.gts, driver-F_SilkS.gto, driver-NPTH-drl_map.gbr]
2020-03-21 removed some unused via holes left on pcb, gerber outputs changed to relative coordinates
    [driver-B_Cu.gbl, driver-B_Mask.gbs, driver-B_SilkS.gbo, driver-Edge_Cuts.gm1, driver-F_Cu.gtl, driver-F_Mask.gts, driver-F_SilkS.gto, driver-NPTH-drl_map.gbr]
